cvra/sensor-board/tof-sensor-board_bottom.png

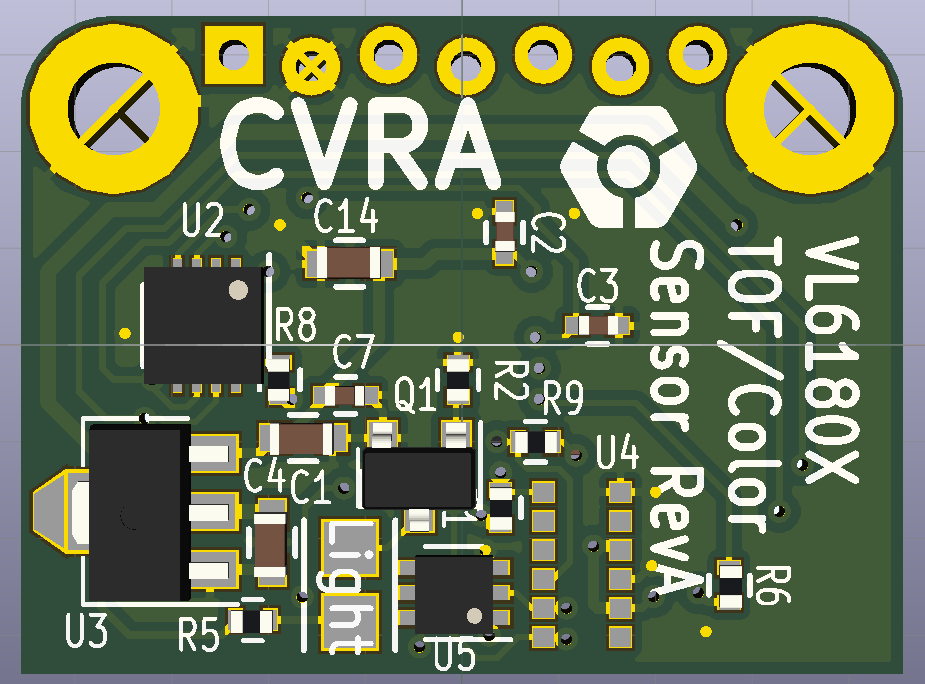
tof-sensor-board_bottom.png
