cvra/sensor-board/tof-sensor-board_top.png

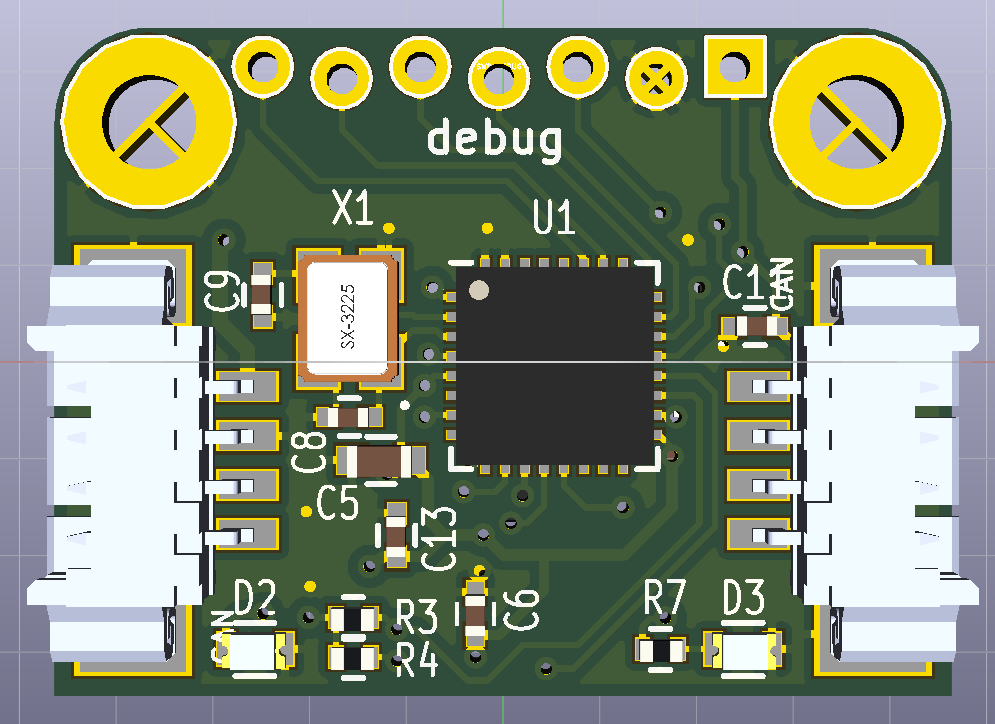
tof-sensor-board_top.png
