cvra/sensor-board/tof-sensor-board-Cmts.User.dxf

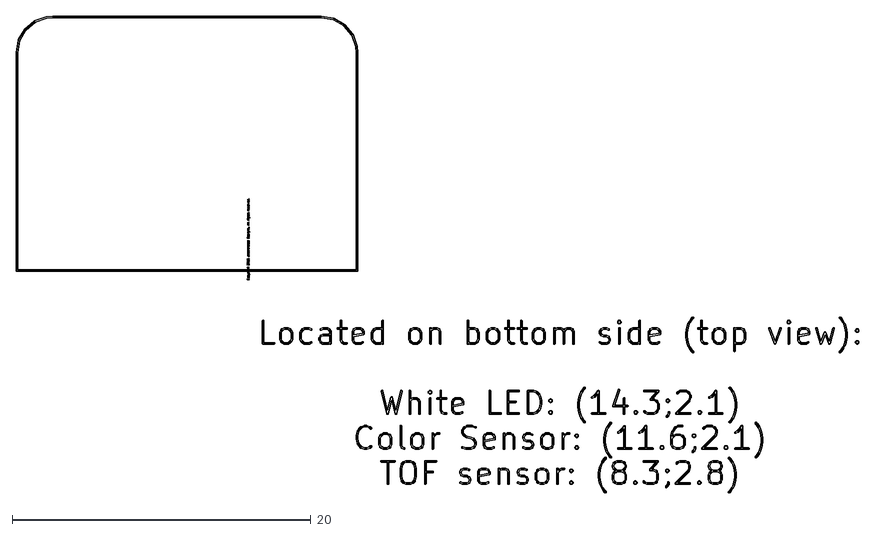
[picture p3: CAD file, 2018-05-31]
tof-sensor-board-Cmts.User.dxf
56.5 x 31.9
