cvra/sensor-board/Dimensions TOF-Color board.pdf

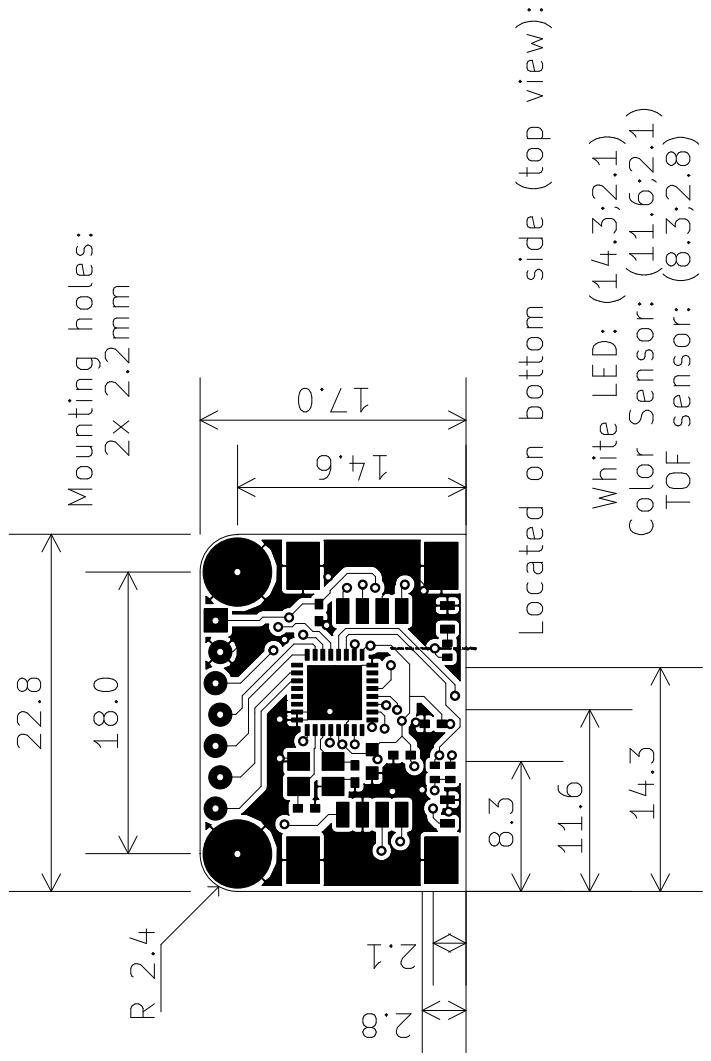
[picture p4: page 1]
