cvra/sensor-board/tof-sensor-board-Cmts.User.pdf

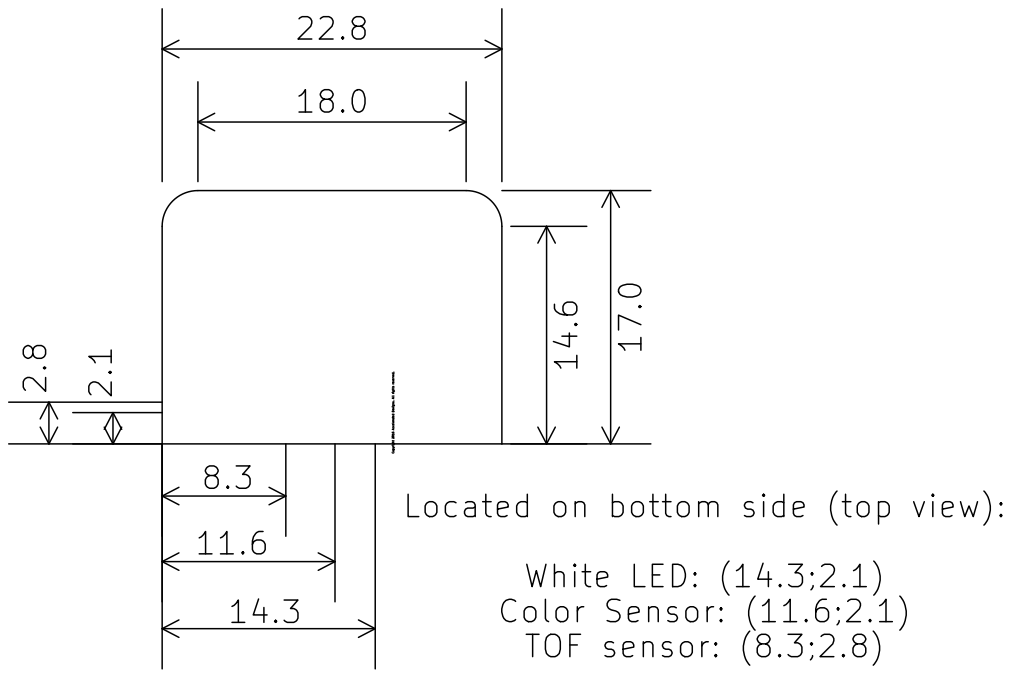
[picture p5: page 1]
