cvra/sensor-board/tof-sensor-board.pdf

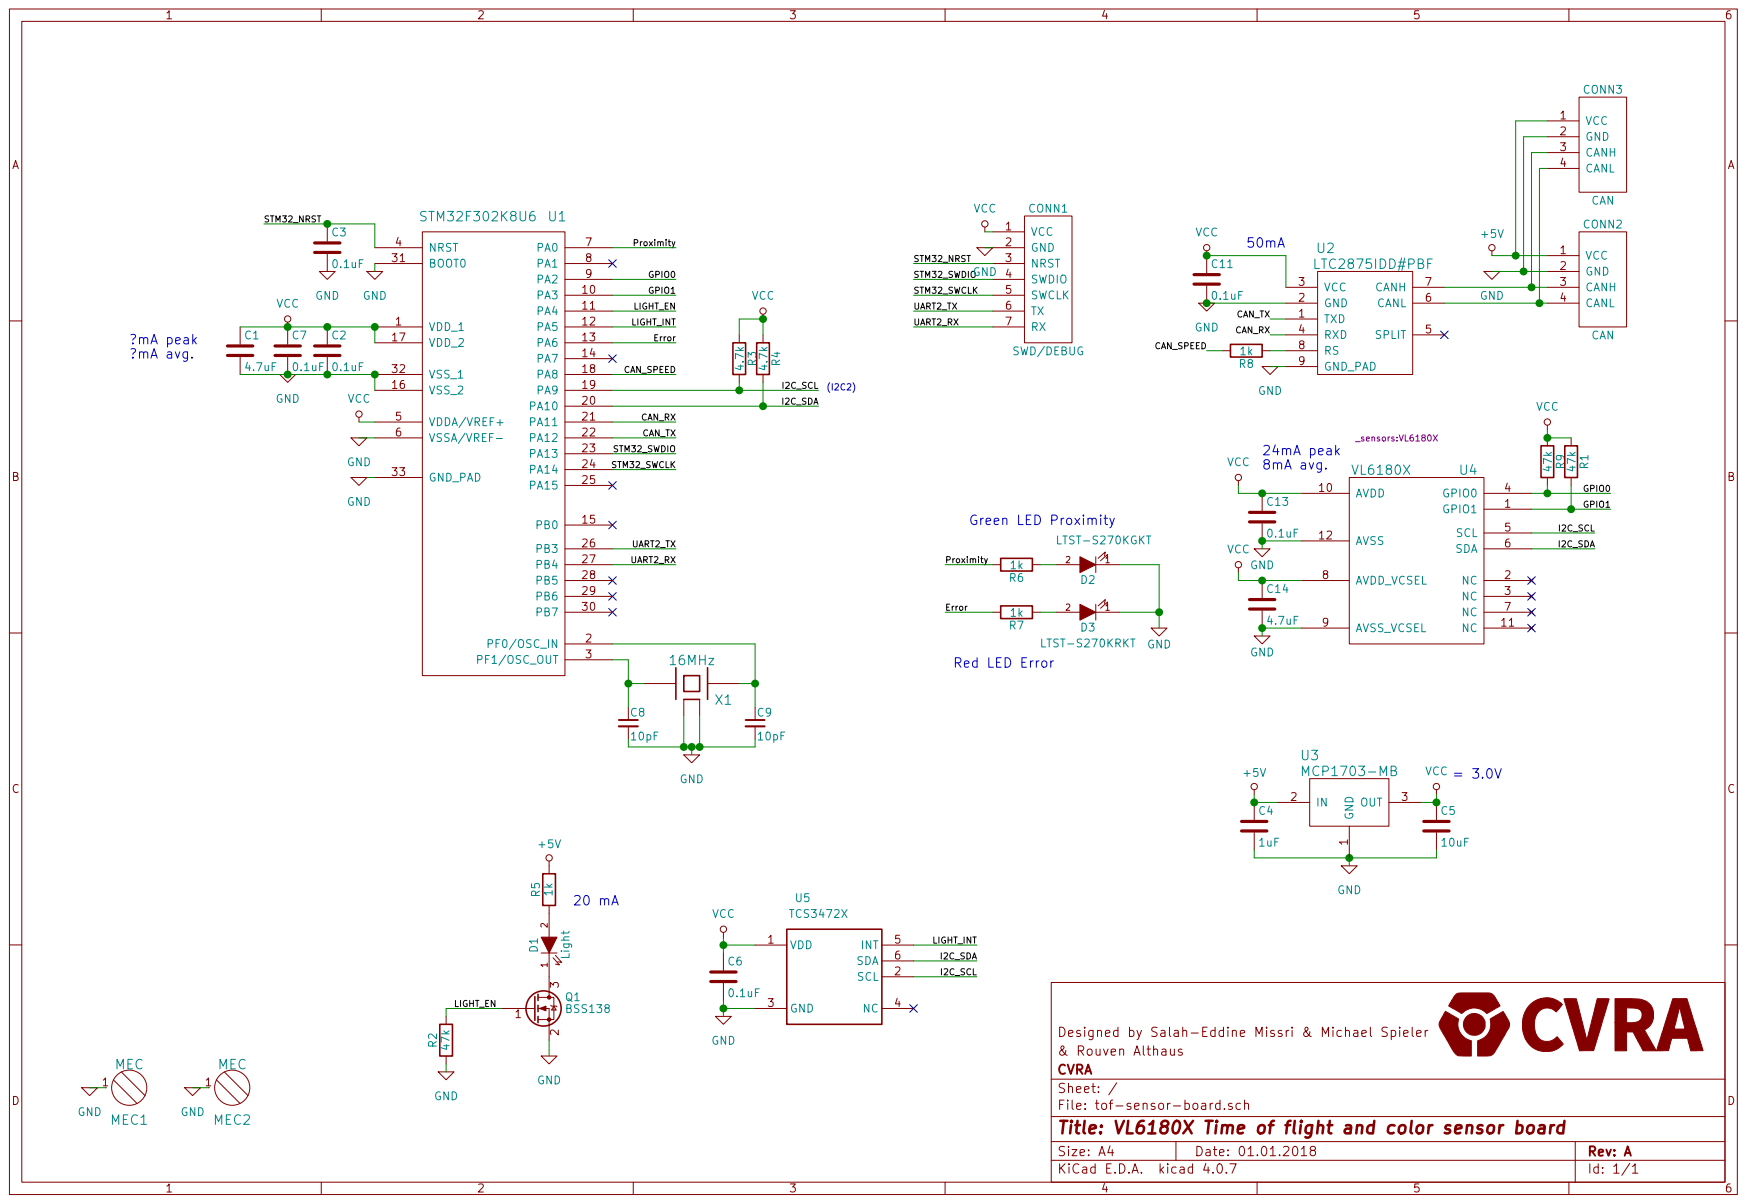
[picture p6: page 1]
