cvra/sensor-board/tof-sensor-board.sch

## KiCad design tof-sensor-board.sch (2016-06-06)

Schematic: tof-sensor-board.sch

Parts:
C1, C14, C15, C16: 4.7uF; C_0402
C2, C4, C11, C12, C13: 0.1uF; C_0402
C3: 0.1uF
C8, C9: 10pF; C_0402
C10: 10uF; C_0402
CONN1: SWD/DEBUG; MODULE
CONN2, CONN3: CAN; _Molex-PicoBlade-SMD-4
D2: PROXIMITY; _0603
D3: ERROR; _0603
D4: SBR130S3-7; _SOD-323
F1: 0ZCK0050FF2E; C_0805
IC1: TLV710; CVRA-PWSON-N6
R3, R4: 4.7k; R_0402
R6, R7: 1k; R_0402
R8: 0; R_0402
R9, R10: 47k; R_0402
U2: LTC2875; DFN-8-1EP_3x3mm_Pitch0.5mm
U3: VL6180X; VL6180X_EdgeMount
X1: 16MHz; _TSX-3225-SMD-XTAL

Notes on the sheet:
Boot from Flash
