cvra/sensor-board/(commit log)

2016-06-06 change STM32F3 QFN32
    [tof-sensor-board.sch]
2018-05-31 Update version
    [tof-sensor-board-BOM.csv, tof-sensor-board-BOM.ods, tof-sensor-board-Cmts.User.dxf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]
2019-04-16 Update BOM
    [BOM.csv, tof-sensor-board-BOM.csv, tof-sensor-board-BOM.ods]
